NguyenVuQuocMinh/sky130-ldo-regulator/doc/ldo_sky130.pdf

# A 1.5 V, 50 mA PMOS LDO in SkyWater sky130: schematic, layout and sign-off with the open PDK decks

### Vu-Quoc-Minh Nguyen

### 09 November 2026

Abstract

A low-dropout regulator (VIN = 1.8 V, VOUT = 1.5 V, IL up to 50 mA, CL = 2.2 µF) is designed in SkyWater sky130 with the 1.8 V devices, laid out in Electric by a script, and checked with the official open-source decks of the PDK: KLayout DRC (sky130A_mr.drc: 0 violations) and KLayout LVS (sky130.lvs: netlists match, including the poly resistors). Current densities are checked against the limits of the SkyWater technology LEF; the first layout failed them and the power routing was redone. Parasitics are extracted with KLayout-PEX (2.5D engine, RC) and the performance is simulated again on the extracted netlist. All numbers in this report are produced by the scripts of the repository.

## 1 Specification and result summary

Table 1: Schematic (typical corner, 27 °C) against post-layout (extracted RC netlist). †
: the phase does not reach −180◦ below 1 GHz. Schematic DC sweeps: 0.1 mA / 2 mV steps; post-layout: 0.5 mA / 10 mV steps.
quantity | target | schematic | post-layout
VOUT at IL = 0.1 mA (V) | 1.5 | 1.5006 | 1.5008
VOUT at IL = 50 mA (V) | | 1.4959 | 1.4948
load regulation 0.1→50 mA (mV) | | 4.73 | 6.08
line regulation 1.7–1.9 V, 0.1 mA (mV/V) | | 14.2 | 16.5
line regulation 1.7–1.9 V, 50 mA (mV/V) | | 23.0 | 25.1
dropout (VOUT −1%) at 50 mA (mV) | | 142 | 170
quiescent current at 1.8 V (µA) | | 64.7 | 64.3
PSRR at 1 kHz, 0.1 mA (dB) | | 35.6 | 36.0
PSRR at 1 kHz, 50 mA (dB) | | 33.6 | 33.2
phase margin, 0.1 mA (°) | ≥ 45 | 89.0 | 89.7
phase margin, 1 mA (°) | | 89.5 | 91.6
phase margin, 10 mA (°) | | 85.9 | 98.6
phase margin, 50 mA (°) | | 80.2 | 101.6
unity-gain frequency, 0.1 mA (kHz) | | 43 | 43
unity-gain frequency, 50 mA (kHz) | | 1519 | 1369
gain margin, 0.1 mA (dB) | | 74 | none†
gain margin, 50 mA (dB) | | 56 | none†
load step: dip below the 0.1 mA level (mV) | | 4.64 | 6.01
load step: peak above the 50 mA level (mV) | | 4.62 | 6.01

Process corners (schematic): tt, ss, ff, sf, fs, ll, hh × −40, 27, 125 °C × VIN = 1.7, 1.8, 1.9 V (63 cases): VOUT = 1.4922–1.5202 V at 0.1 mA and 1.4877–1.5003 V at 50 mA, quiescent current 63.4–66.7 µA, lowest phase margin 75.6° (ss, -40 °C, VIN = 1.9 V).

## 2 Circuit

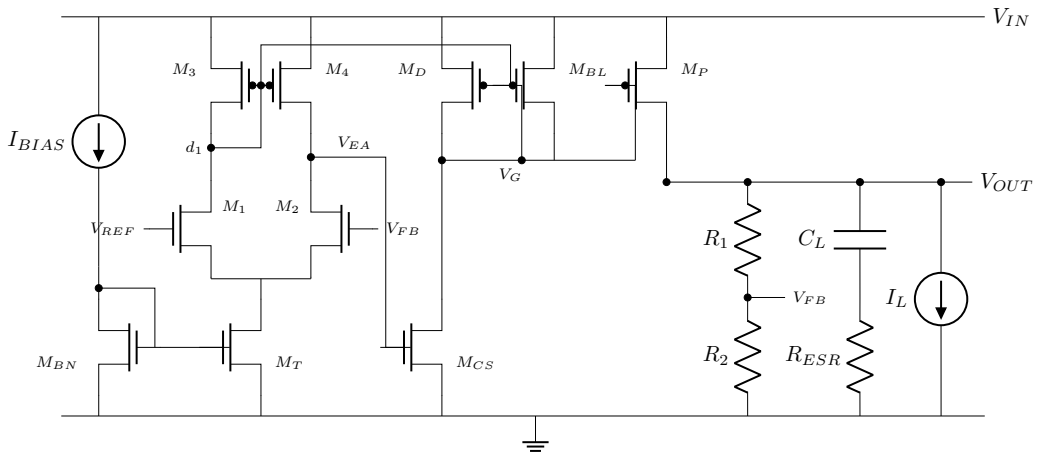
[picture p7: figure]
VIN; IBIAS; MBN; VREF; VEA; MCS; MBL; VOUT; RESR

Figure 1: The LDO. On chip: everything except VREF , IBIAS, CL, RESR and IL.

The error amplifier is a five-transistor OTA with an NMOS input pair (M1: VREF , M2: VF B) and a PMOS mirror load. Its output VEA drives the common-source NMOS MCS, which sinks its current from the diode-connected PMOS MD. MD and the pass device MP have the same channel length and finger width, so they form a 1 : 160 current mirror and the gate node VG has the low impedance 1/gm,D: the pole at the large gate capacitance of MP moves to high frequency, and the output pole set by CL dominates. The bleeder MBL (a mirror of M3) supplies a small fixed current into VG, so that the subthreshold leakage of MCS at hot corners, multiplied by the mirror ratio, does not exceed the minimum load. The divider is made of identical xhigh_po poly resistors (w = 0.35 µm, l = 4.27 µm each): R1 = 2 units, R2 = 4 units, so VOUT = VREF (1 + R1/R2) = 1.50 V.

Table 2: Device sizes (scripts/sizes.json). W per finger.

device | type | W (µm) | L (µm) | fingers
MBN | nfet_01v8 | 4 | 1 | 1
MT | nfet_01v8 | 4 | 1 | 4
M1, M2 | nfet_01v8 | 8 | 1 | 2
M3, M4 | pfet_01v8 | 8 | 1 | 2
MCS | nfet_01v8 | 10 | 0.5 | 2
MD | pfet_01v8 | 10 | 0.15 | 1
MBL | pfet_01v8 | 4 | 1 | 1
MP | pfet_01v8 | 10 | 0.15 | 160
R1, R2 units | res_xhigh_po_0p35 | 0.35 | 4.27 | 2 + 4 (+2 dummies)
bias, load | – | IBIAS = 10 µA, VREF = 1 V, CL = 2.2 µF, RESR = 10 mΩ

## 3 Layout

The layout is generated by layout/gen_layout.py in Electric 9.08 (built-in skywater130 technology) and exported to GDS; layout/postproc.py then adds the two things Electric does not write: the poly_rs marker (66/13) on the resistor bodies, without which the decks see no precision resistor, and the pin labels (70/5). Size ≈ 155.3 × 40.6 µm.

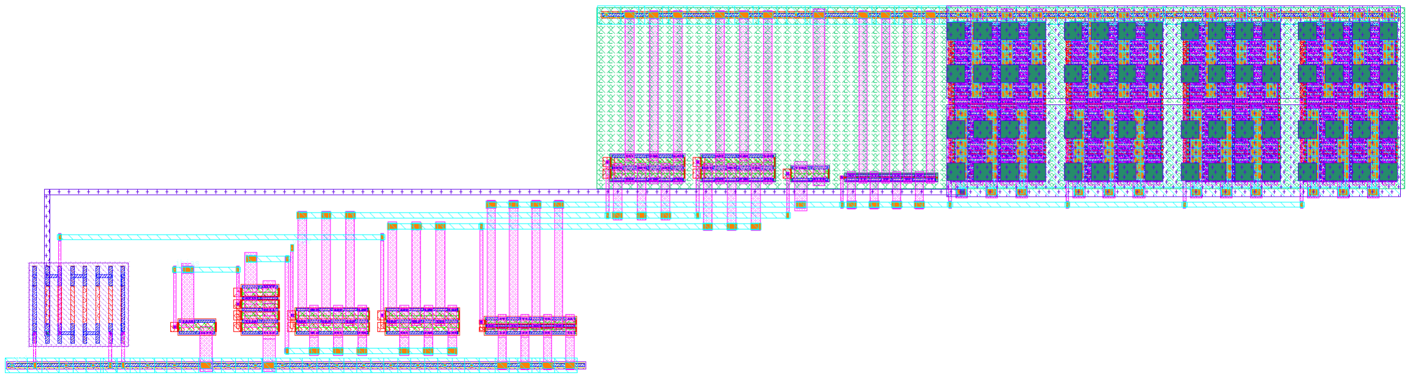
[picture p8: figure]

Figure 2: ldo_final.gds (KLayout, sky130 layer colours). Left to right: divider (6 units + 2 dummies), NMOS row (MBN , MT , M1, M2, MCS) with the met3 signal tracks above it, PMOS row (M3, M4, MBL, MD) in the n-well, and the pass device (4 columns × 40 fingers) under the power plates.

Power path. The pass device carries the whole load current. Its drain and source rows are joined by vertical met2 straps (three of each per column). In the first layout the straps ended on a met3 rail of 1 µm (vout) or 2 µm (vin) width, and the vin pin sat 45 µm away from the array; 50 mA in these rails is 50 and 25 mA/µm, far above the met3 limit of 6.8 mA/µm (Sec. 4.3). The final layout covers the array with two met3 + met4 plates, vout over the lower half and vin over the upper half (about 9.4 µm tall each). Every drain (source) row inside the vout (vin) plate has a via2 of 3 × 2 cuts from its strap, the two plate layers are joined by 800 / 801 via3 cuts each, and the vin and vout pins are at the plate centres.


Figure 3: One pass column and a half: the via2 stacks on the drain straps (lower half, vout plate) and on the source straps (upper half, vin plate), and the via3 arrays.

## 4 Physical verification

### 4.1 DRC

Deck: sky130A_mr.drc (efabless, release 2024.2.11_01.09), KLayout 0.30.12, front end, back end and off-grid checks. Result on ldo_final.gds: 0 violations. The first run had nine: eight licon.1 (the 0.19×2.0 µm contact slots of the resistors, exempt only when poly_rs is present, which Electric had not written) and one m3.6 (a 0.16 µm² met3 pad in a via stack, now 0.36 µm²
). Electric’s own DRC still lists errors (psdm spacing between overlapping implant shapes, poly-to-diffusion spacing, and met3 spacing where the plates overlap wires that Electric treats as other nodes); the official deck reports none of them.

### 4.2 LVS

Deck: sky130.lvs (efabless sky130_klayout_pdk, commit 13d25721), against a CDL netlist written from sizes.json (scripts/ldo_cdl.py). Result: netlists match. After the deck combines the fingers and the series resistor units, the extracted netlist is:

Table 3: Devices extracted by the LVS deck (after combining parallel fingers and series units).

device | model | W (µm) | L (µm) / R
MBL | pfet_01v8 | 4 | 1
MD | pfet_01v8 | 10 | 0.15
MP | pfet_01v8 | 1600 | 0.15
M3 | pfet_01v8 | 16 | 1
M4 | pfet_01v8 | 16 | 1
M1 | nfet_01v8 | 16 | 1
MCS | nfet_01v8 | 20 | 0.5
M2 | nfet_01v8 | 16 | 1
MT | nfet_01v8 | 16 | 1
MBN | nfet_01v8 | 4 | 1
R1 | res_xhigh_po_0p35 | 0.35 | l = 8.54 µm, 48.8 kΩ
R2 | res_xhigh_po_0p35 | 0.35 | l = 17.08 µm, 97.6 kΩ
dummies (parallel) | res_xhigh_po_0p35 | 0.7 | l = 4.27 µm, 12.2 kΩ

To check that the flow can fail, the comparison was repeated with four deliberately wrong netlists (layout/lvs_negative_test.py): 150 instead of 160 pass fingers, M2’s gate on VREF , one resistor unit 5 µm long, L(MCS) = 0.6 µm. All four were reported as mismatches, the correct netlist as a match.

### 4.3 Electromigration

Limits: the SkyWater technology LEF sky130_fd_sc_hd.tlef (average DC current, junction temperature 90 °C): 2.8 mA/µm (met1, met2), 6.8 mA/µm (met3, met4), and per cut 0.36 (mcon), 0.29 (via), 0.48 (via2, via3) mA. The check (layout/em_check.py) measures widths and cut counts on the GDS and assumes the worst case for each element: the whole current that a branch can carry passes through its narrowest element, with no sharing. At IL = 50 mA each of the 160 fingers carries 0.31 mA.

Table 4: EM check of the pass-device path at 50 mA, worst-case bounds.

element | I (mA) | limit (mA) | measured
mcon, one S/D row | 0.625 | 9.720 | 27 cuts
met1 row bar (all row current, one side) | 0.625 | 0.728 | height 0.26 µm
via1, one row into one strap (whole row) | 0.625 | 1.160 | 4 cuts
met2 strap at the plate edge | 2.292 | 3.668 | width 1.31 µm
via2 node in vout plate (strap current) | 2.292 | 2.880 | 6 cuts, 30 nodes in column 0
met3 vout plate, full IL | 50.000 | 63.954 | height 9.40 µm
met4 vout plate, full IL | 50.000 | 63.954 | height 9.40 µm
via3 vout plate (if the pin is met4) | 50.000 | 384.480 | 801 cuts
via2 node in vin plate (strap current) | 2.188 | 2.880 | 6 cuts, 33 nodes in column 0
met3 vin plate, full IL | 50.000 | 64.566 | height 9.50 µm
met4 vin plate, full IL | 50.000 | 64.566 | height 9.50 µm
via3 vin plate (if the pin is met4) | 50.000 | 384.000 | 800 cuts

Every element is within its limit. The closest are the met1 bar of a contact row (0.625 of 0.728 mA, with all of the row’s current assumed to leave on one side) and the plate via2 (2.29 of 2.88 mA, 2.19 of 2.88 mA). The limits are for 90 °C; at the 125 °C corner they are lower, and this was not checked.

## 5 Parasitic extraction and post-layout simulation

Extraction. KLayout-PEX 0.8.1, 2.5D analytical engine, mode RC, sky130A technology data of the tool. The raw netlist has 34,299 resistors and 64,669 capacitors. ngspice needs about ten minutes for one operating point of it; the netlist was therefore reduced with the TICER pass of the same tool (time-constant threshold 10 ps, i.e. an error per eliminated node of about 2πfτ = 6×10−5 at 1 MHz, exact at DC) to 4,023 resistors and 22,567 capacitors. The full and the reduced netlist give the same operating point (VOUT = 1.50085 V, supply current 164.303 µA at 0.1 mA load). The DC sweeps (load and line regulation, dropout, quiescent current) use the same netlist without its capacitors, which do not enter a DC solution; the AC and transient runs use the full reduced RC netlist. The substrate node of the extraction is tied to ground; the 2.5D engine has no substrate resistance. For the loop gain, the gate of M2 is cut from the feedback net in the extracted netlist and the loop is broken there, as in the schematic.

Results. Table 1 compares the two. At light load the two agree closely. At 50 mA the extracted netlist has a lower loop gain (45.7 against 48.3 dB) and a higher phase margin (101.6° against 80.2°). The operating point at 50 mA shows where this comes from (scripts/check_sense_point.py): the pass-device drains sit at 1.5095 V, the top of the divider at 1.4955 V and the vout pin at 1.4947 V, i.e. 280 mΩ of wiring (diffusion, contacts, straps, plate) lies between the drains and the feedback tap and 14 mΩ between the tap and the pin. Inserting these two resistors into the schematic raises its phase margin at 50 mA from 80.2° to 95.5° (unity-gain frequency 1.57 MHz), so most of the difference is this series resistance. Above about 10 MHz the post-layout loop gain does not roll off but stays near −16 dB (Fig. 4). This is capacitive coupling into the feedback net, which bypasses the loop break: moving its 224 coupling capacitors (4.8 fF in total) to ground lowers |T| above 100 MHz from −16 to −84 dB at 0.1 mA and changes the phase margin at 50 mA only from 101.6° to 100.1° (scripts/check_fb_coupling.py). The remaining 5° were not attributed. (Treating the same resistance as extra ESR of CL does not reproduce the result: it moves the unity-gain frequency to 25 MHz, scripts/check_-route_esr.py.) The same resistance costs ≈14 mV of headroom at 50 mA, which appears in the post-layout dropout. Phase margin against the ESR of CL = 0, 10 mΩ, 1 Ω, post-layout (schematic in brackets): at 0.1 mA 89° (89°), 90° (89°), 126° (125°); at 50 mA 93° (69°), 102° (80°), 62° (55°). The loop stays stable in all of them.


Figure 4: Loop gain, schematic (left) and post-layout (right), at IL = 0.1, 1, 10, 50 mA.


Figure 5: Load step 0.1 mA → 50 mA → 0.1 mA (1 µs edges), schematic (left) and post-layout (right).

## 6 A numerical artefact in the corner sweep

The first corner sweep read VOUT at 50 mA as the last point of a DC sweep of IL. At hh, 27 °C, VIN = 1.8 V it gave 1.69 V. The circuit is not at fault: an operating point at 50 mA and a transient run both give 1.4959 V, and in the DC sweep 6 of its 500 points jump to non-physical values (one at −2128 V) while the others lie between 1.4959 and 1.5005 V (scripts/check_hh.py). The sweep now takes VOUT from a separate operating point at each load; only this one case changed.

## 7 Limitations

- The parasitic extraction is the 2.5D analytical engine of one tool; it was not compared with Magic or a field solver, and it has no substrate network.
- Corners were simulated on the schematic only; post-layout runs are at the typical corner, 27 °C, VIN = 1.8 V. The post-layout ESR sweep has three points (0, 10 mΩ, 1 Ω) and the post-layout DC sweeps a coarser step than the schematic ones, because each post-layout AC run takes about five minutes.
- The block has no pads, ESD, density fill or seal ring; VREF and IBIAS are ideal sources off chip.
- The pin-and-device-class cross-check of KLayout-PEX did not run (its netlist reader does not accept the three-terminal resistor lines of the CDL file); the connectivity is covered by the LVS deck above.

## 8 Reproducing

cd scripts && python sim_all.py && python corners.py && python check_hh.py cd ../layout && python gen_layout.py && python run_drc.py && python run_lvs.py python lvs_negative_test.py && ..\.venv_pex\Scripts\python em_check.py ..\.venv_pex\Scripts\kpex extract --pdk sky130A --gds ldo_final.gds --cell ldo --2.5D --mode RC --out-dir pex
python -m klayout_pex.netlist reduce --ticer-tau 10p --ticer-max-degree 8 ...
cd ../scripts && python run_postlayout.py && python check_sense_point.py
cd ../doc && python build_doc.py

Tools: ngspice 46, Electric 9.08, KLayout 0.30.12, KLayout-PEX 0.8.1, SkyWater sky130 models (sky130_-fd_pr).
