NguyenVuQuocMinh/sky130-ldo-regulator/figures/gm_over_id.png

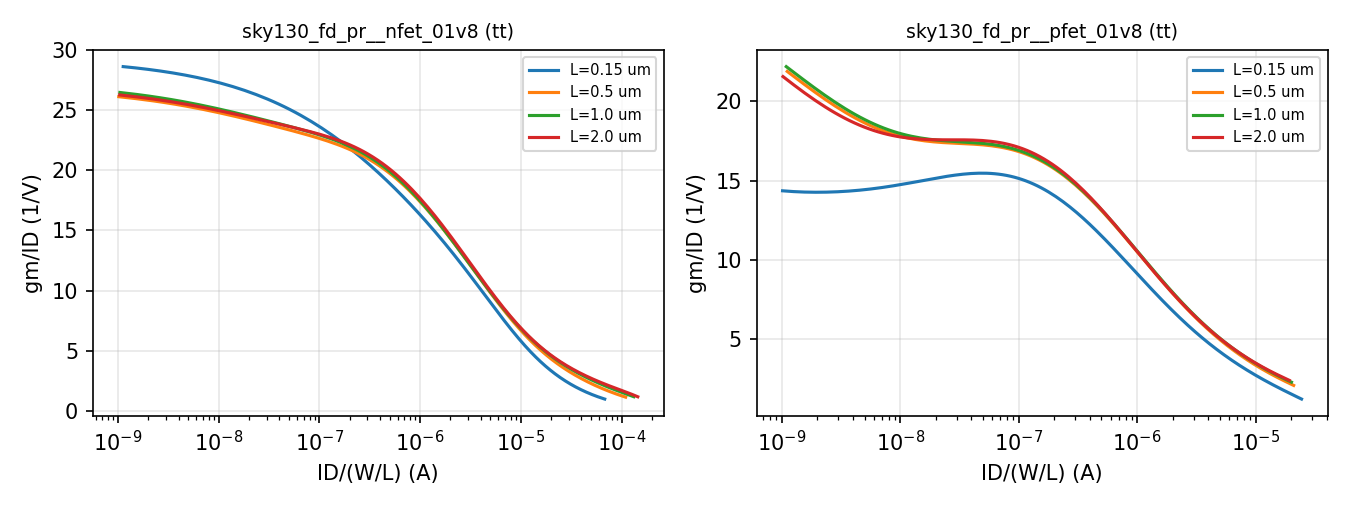
figures/gm_over_id.png
