NguyenVuQuocMinh/sky130-ldo-regulator/figures/line_dropout_pex.png

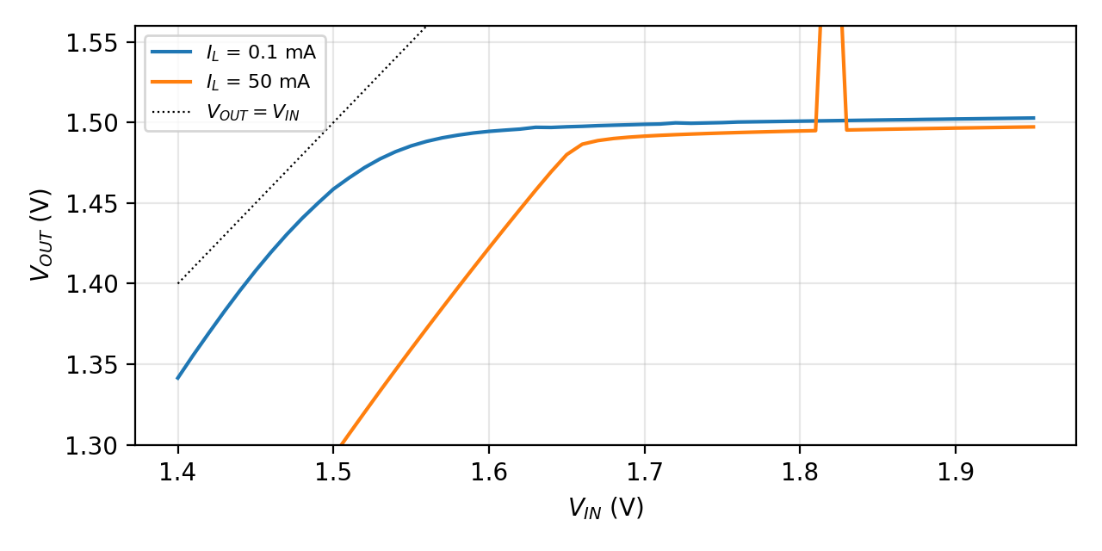
figures/line_dropout_pex.png
