NguyenVuQuocMinh/sky130-ldo-regulator/figures/line_dropout_sch.png

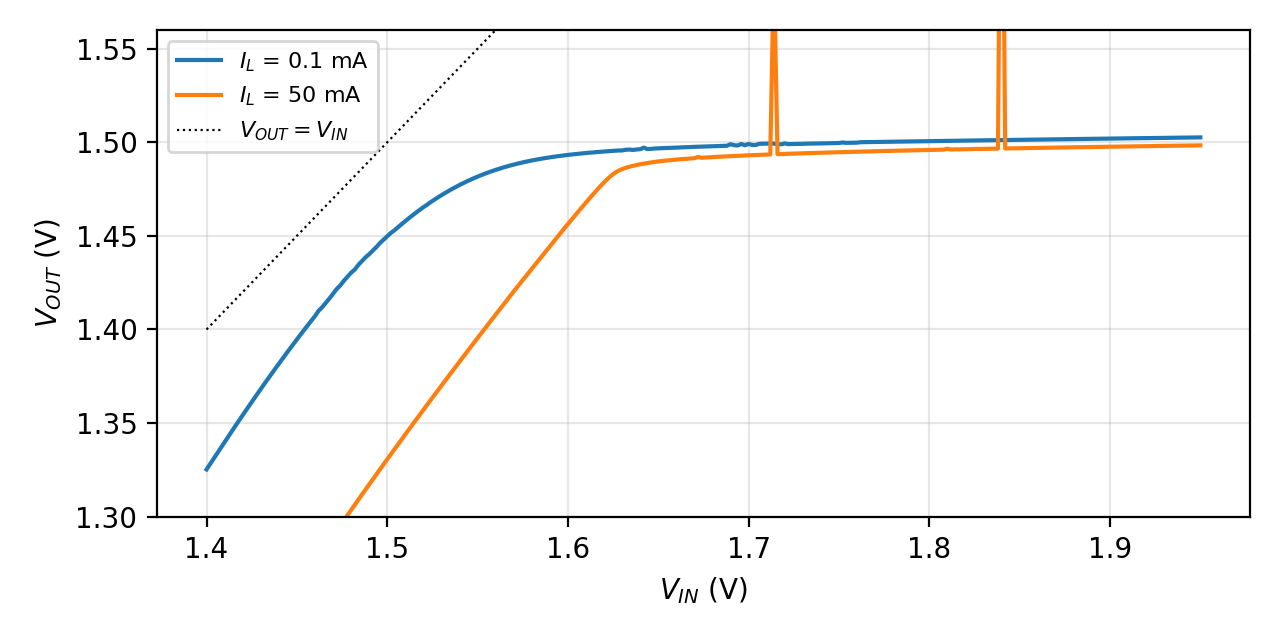
figures/line_dropout_sch.png
