NguyenVuQuocMinh/sky130-ldo-regulator/figures/load_regulation_pex.png

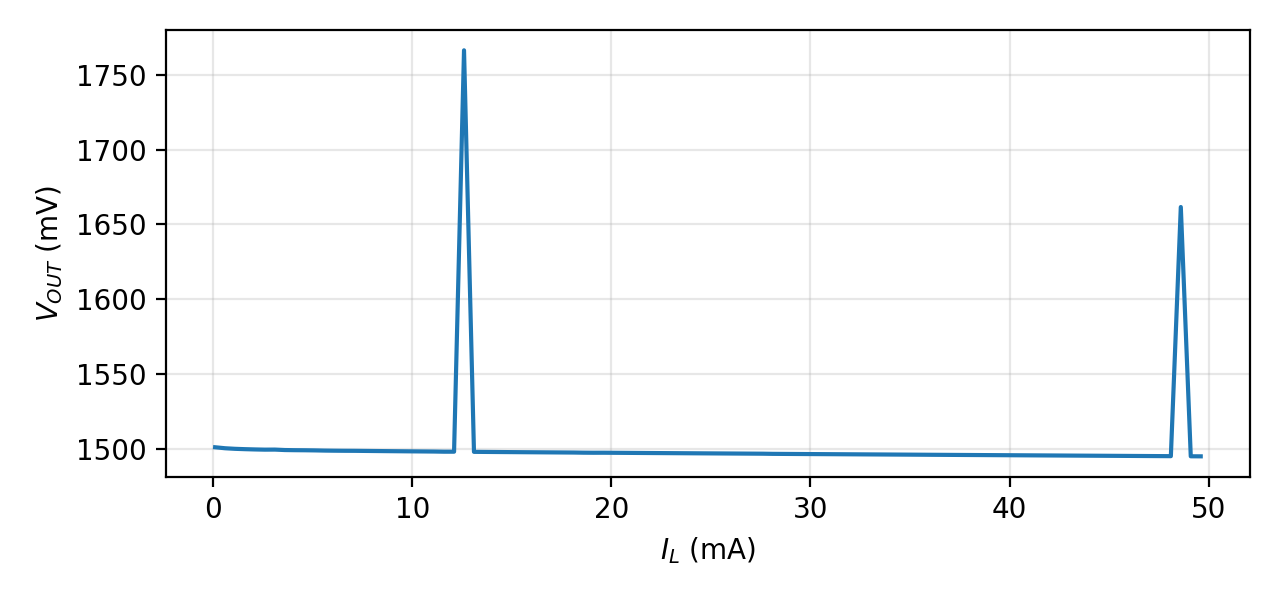
figures/load_regulation_pex.png
