NguyenVuQuocMinh/sky130-ldo-regulator/figures/load_regulation_sch.png

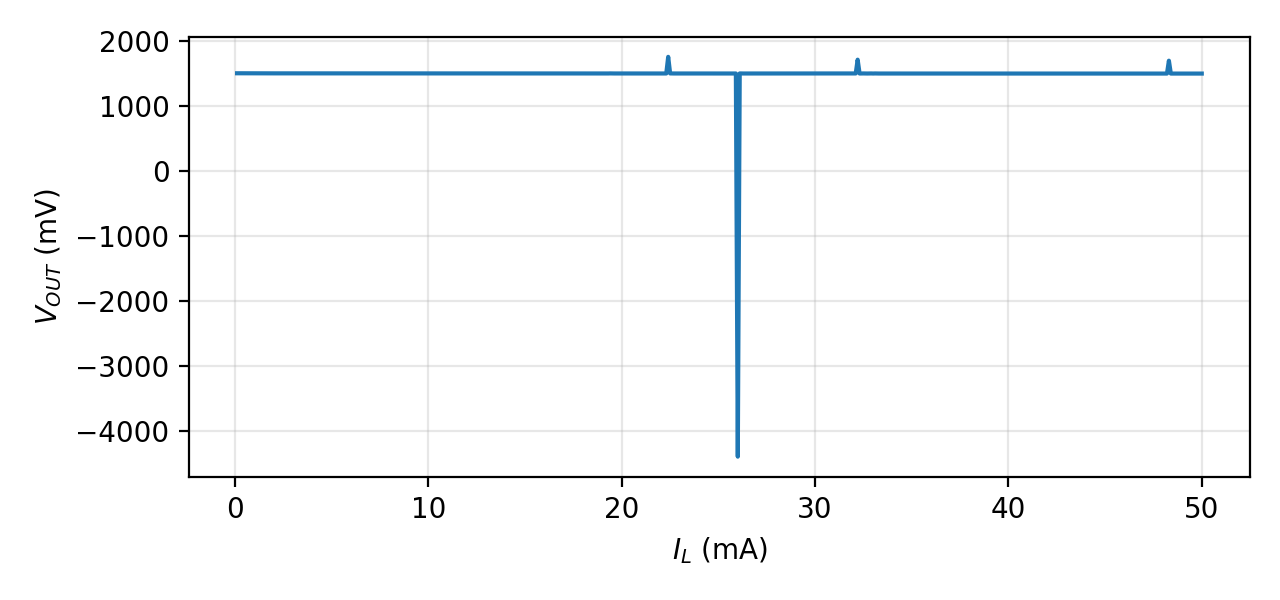
figures/load_regulation_sch.png
