NguyenVuQuocMinh/sky130-ldo-regulator/figures/pm_vs_esr_pex.png

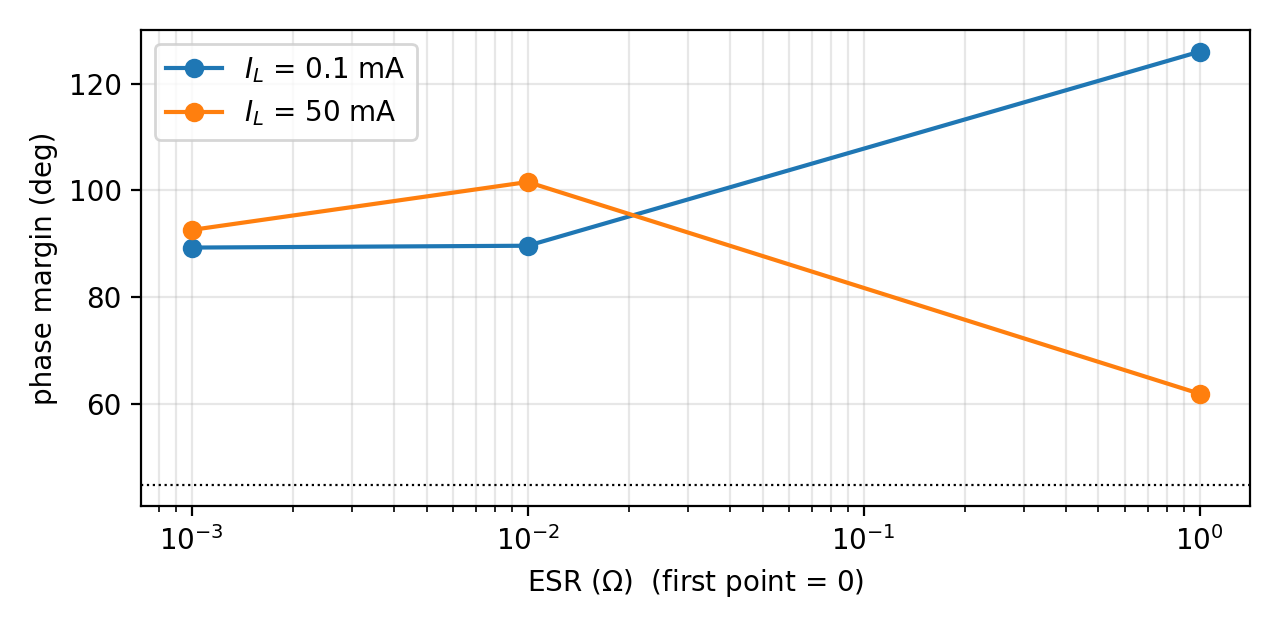
figures/pm_vs_esr_pex.png
