NguyenVuQuocMinh/sky130-ldo-regulator/figures/pm_vs_esr_sch.png

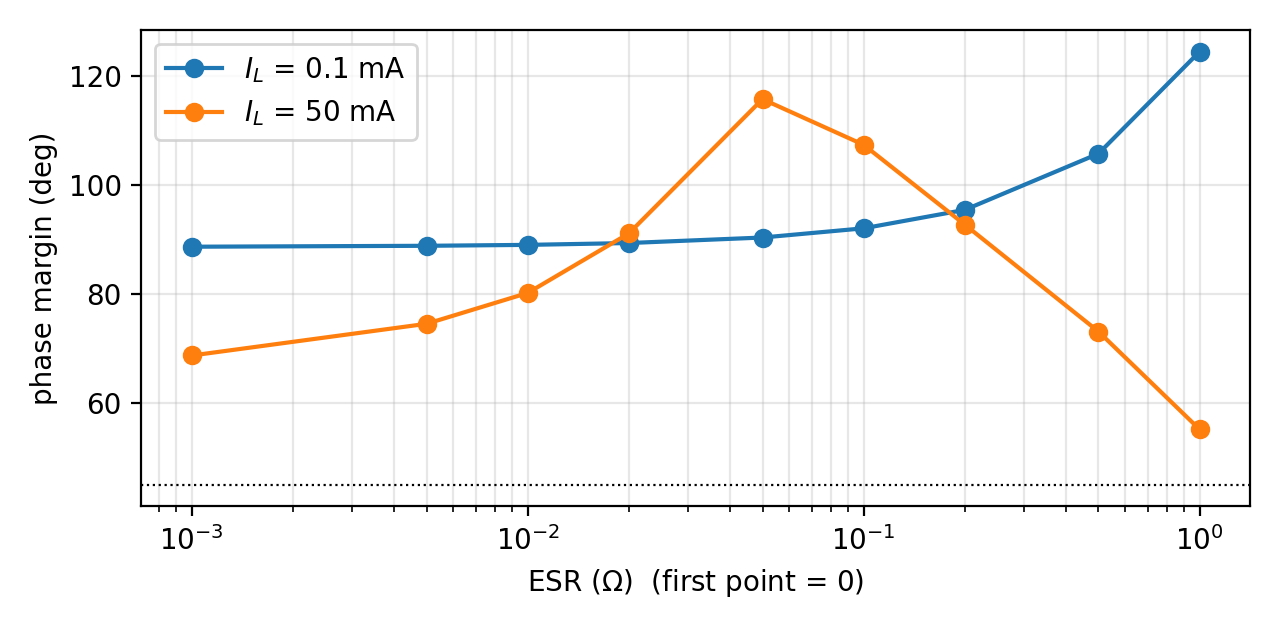
figures/pm_vs_esr_sch.png
