NguyenVuQuocMinh/sky130-ldo-regulator/figures/psrr_pex.png

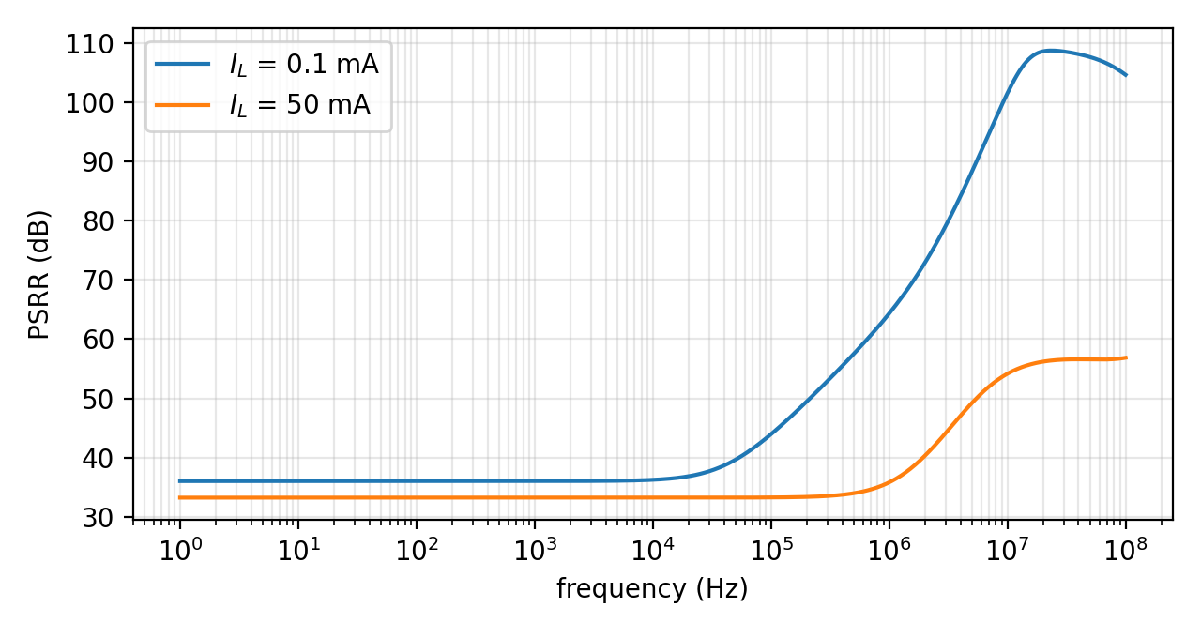
figures/psrr_pex.png
